pausabater13/IRIintern_2023spring/hardware/README.md

# Thurst Controller Hardware :notebook:

> Hardware files related to the HiDRo thrust controller board.

The hardware CAD files of the board have been created using Kicad.

Inside the **thrust_controller** folder you can find :

- the electrical schematic (*thrust_controller.kicad_sch*)
- the pcb design (*thrust_controller.kicad_pcb*)
- the fabrication files (in **fabrication_outputs**)
