pausabater13/IRIintern_2023spring/documentation/thrust_components.md

# Bill of Materials

## Analog circuits

- [Instrumentation amplifier AD620](https://www.mouser.es/ProductDetail/584-AD620ARZ) **x 1**
- [Operational amplifier OPA317ID](https://www.mouser.es/ProductDetail/595-OPA317IDR) **x 1**

## Digital circuits

- [Microcontroller STM32L011F4P](https://www.mouser.es/ProductDetail/511-STM32L011F4P6) **x 1**
- [RS485 Tranceiver MAX1487ESA](https://www.mouser.es/ProductDetail/700-MAX1487CSA) **x 1**

## Power regulators

- [Linear regulator TPS79133](https://www.mouser.es/ProductDetail/595-TPS79133DBVR) **x 2**

## Connectors

> For pixhawk & esc

- [3 pins horizontal header](https://www.mouser.es/ProductDetail/855-M20-8900305) **x 2**

> For debug & RS485

- [4 pins gh connector](https://es.rs-online.com/web/p/conectores-macho-para-pcb/7521797) **x 3**

## Passive components

 > For power decoupling

- [0.1uF capacitor](https://www.mouser.es/ProductDetail/80-C0805C104K8RAUTO) **x 15**
- [1uF capacitor](https://www.mouser.es/ProductDetail/80-C0805C105K4R7800) **x 2**
- [10uF capacitor](https://www.mouser.es/ProductDetail/80-C0805C106K8P) **x 4**

 > For the analog section

- [10uF Tantalum capacitor](https://www.mouser.es/ProductDetail/74-TMCP1A106KTRF) **x 1**

> For visual checking

- [Blue led](https://www.mouser.es/ProductDetail/604-APA2107LVBCD) **x 1**
- [Green led](https://www.mouser.es/ProductDetail/604-APA2107LZGCK) **x 1**

> For the diodes

- [1.18k Ohm resistor](https://www.mouser.es/ProductDetail/71-CRCW0805-1.18K-E3) **x 1**
- [330 Ohm resistor](https://www.mouser.es/ProductDetail/71-CRCW0805330RFKEAC) **x 1**

> For the voltage divider

- [200 Ohm resistor](https://www.mouser.es/ProductDetail/71-CRCW0805200RFKEBC) **x 1**
- [100 Ohm resistor](https://www.mouser.es/ProductDetail/71-CRCW0805100RFKEAC) **x 1**
