pausabater13/IRIintern_2023spring/hardware/thrust_controller/thrust_controller.kicad_pcb

## KiCad design hardware/thrust_controller/thrust_controller.kicad_pcb (2023-05-12)

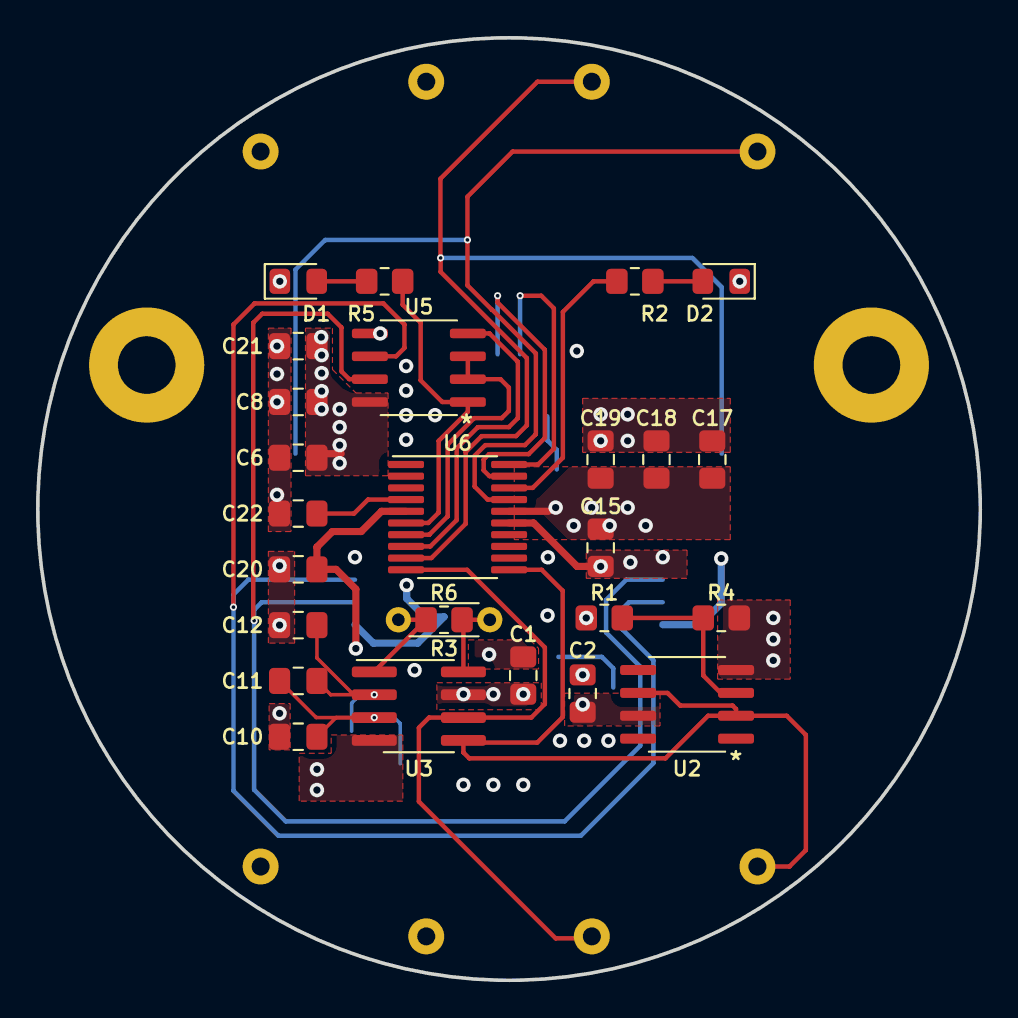
[picture p1: board thrust_controller.kicad_pcb from above]

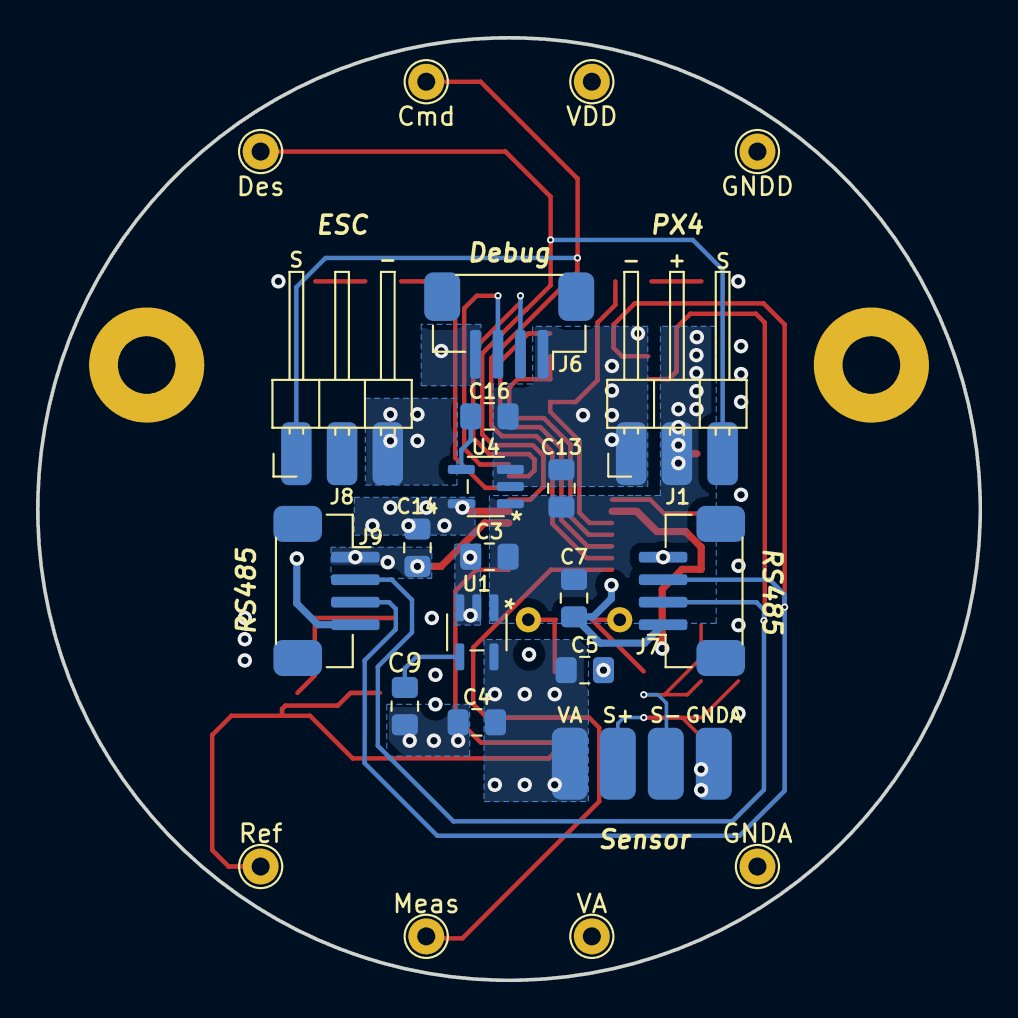
[picture p2: board thrust_controller.kicad_pcb from below]

Board: 4 copper layers, 52.4 x 52.4 mm, 55 parts (27 on the bottom side), 26 nets.

Parts:
C1, C2, C3, C9, C10, C11, C12, C13, C16, C17, C18, C19, C20, C21, C22: 0.1 μF; C_0805_2012Metric_Pad1.18x1.45mm_HandSolder
C4, C14: 1 μF; C_0805_2012Metric_Pad1.18x1.45mm_HandSolder
C5: 10 μF Tantalum; C_0805_2012Metric_Pad1.18x1.45mm_HandSolder
C6, C7, C8, C15: 10 μF; C_0805_2012Metric_Pad1.18x1.45mm_HandSolder
D1: BLUE LED; LED_0805_2012Metric_Pad1.15x1.40mm_HandSolder
D2: YELLOW LED; LED_0805_2012Metric_Pad1.15x1.40mm_HandSolder
H1, H2: MountingHole; MountingHole_3.2mm_M3_Pad
J1: px4_con; PinHeader_1x03_P2.54mm_Horizontal
J2: VS; SolderWirePad_1x01_SMD_1x2mm
J3: S+; SolderWirePad_1x01_SMD_1x2mm
J4: S-; SolderWirePad_1x01_SMD_1x2mm
J5: GND; SolderWirePad_1x01_SMD_1x2mm
J6: debug_con; JST_GH_SM04B-GHS-TB_1x04-1MP_P1.25mm_Horizontal
J7, J9: rs485_con; JST_GH_SM04B-GHS-TB_1x04-1MP_P1.25mm_Horizontal
J8: esc_con; PinHeader_1x03_P2.54mm_Horizontal
R1, R4: R; R_0805_2012Metric_Pad1.20x1.40mm_HandSolder
R2: 260 Ω; R_0805_2012Metric_Pad1.20x1.40mm_HandSolder
R3: Rg; R_0805_2012Metric_Pad1.20x1.40mm_HandSolder
R5: 440 Ω; R_0805_2012Metric_Pad1.20x1.40mm_HandSolder
R6: Test; R_Axial_DIN0204_L3.6mm_D1.6mm_P5.08mm_Horizontal
TP1, TP2, TP3, TP4, TP5, TP6, TP7, TP8: TestPoint; TestPoint_THTPad_D2.0mm_Drill1.0mm
U1, U4: TPS79133DBVT
U2: OPA317ID
U3: AD620; SOIC-8_3.9x4.9mm_P1.27mm
U5: MAX485E; MAX1487ESA&plus_
U6: STM32L011F4Px; TSSOP-20_4.4x6.5mm_P0.65mm

Connections:
+3.3V: C14.1, C15.1, C17.1, C18.1, C19.1, J6.4, J7.4, J9.4, TP5.1, U4.5 (OUT), U6.16 (VDD)
+3.3VA: C1.1, C2.1, C4.1, C5.1, C10.1, C20.1, J2.1, R1.1, TP1.1, U1.5 (OUT), U2.7 (V+), U3.7 (Vs+), U6.5 (VDDA)
+5V: C3.1, C6.1, C7.1, C8.1, C13.1, C21.1, J1.2, U1.1 (IN), U4.1 (IN), U5.8 (VCC)
A: J7.3, J9.3, U5.6 (A)
B: J7.2, J9.2, U5.7 (B)
Cmd: J8.1, TP7.1, U6.9 (PA3)
Des: J1.3, TP2.1, U6.17 (PA9)
GNDA: C1.2, C2.2, C3.2, C4.2, C5.2, C6.2, C7.2, C8.2, C9.2, C12.2, C13.2, C14.2, C15.2, C16.2, C17.2, C18.2, C19.2, C20.2, C21.2, C22.2, D1.1 (K), D2.1 (K), J1.1, J5.1, J6.1, J7.1, J8.3, J9.1, R4.2, TP6.1, TP8.1, U1.2 (GND), U1.3 (*EN), U2.4 (V-), U3.4 (Vs-), U4.2 (GND), U4.3 (*EN), U5.5 (GND), U6.15 (VSS)
Meas: TP3.1, U3.6, U6.10 (PA4)
unnamed: C9.1, U1.4 (BP)
unnamed: C16.1, U4.4 (BP)
unnamed: C22.1, U6.4 (NRST)
unnamed: D1.2 (A), R5.1
unnamed: D2.2 (A), R2.2
unnamed: R1.2, R4.1, U2.3 (+)
unnamed: R2.1, U6.18 (PA10)
unnamed: R3.1, R6.1, U3.1 (Rg)
unnamed: R3.2, R6.2, U3.8 (Rg)
unnamed: U5.2 (~RE), U5.3 (DE), U6.7 (PA1)
Ref: TP4.1, U2.2 (-), U2.6, U3.5 (Ref), U6.11 (PA5)
S+: C10.2, C11.1, J3.1, U3.3 (+)
S-: C11.2, C12.1, J4.1, U3.2 (-)
SWCLK: J6.3, U6.20 (PA14)
SWDIO: J6.2, U6.19 (PA13)
USART2_RX: R5.2, U5.1 (RO), U6.6 (PA0)
USART2_TX: U5.4 (DI), U6.8 (PA2)
