pausabater13/IRIintern_2023spring/firmware/5ADC_PWM_PulseLength/Core/Src/main.c

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
/* Includes ------------------------------------------------------------------*/
#include "main.h"

ADC_HandleTypeDef hadc;

TIM_HandleTypeDef htim2;
TIM_HandleTypeDef htim21;

void SystemClock_Config(void);
static void MX_GPIO_Init(void);
static void MX_TIM2_Init(void);
static void MX_ADC_Init(void);
static void MX_TIM21_Init(void);
/* USER CODE BEGIN 0 */
	//##############################ADC INPUT SENSOR - PID CONTROL############################
	float Thrust_measured = 0;//Newtons
	float Thrust_desired = 0;//Newtons
	//##############################PWM OUTPUT##############################
	uint32_t Frequency_output = 4000; //in Hertz. As we want a max pulse of 250us(Duty_output=100%)
	float Duty_output = 0; //From 0 to 1
	uint32_t Pulse_length_output = 150;//in us (microseconds)
	//############################## PWM INPUT##############################
	float Duty_input = 0; //Duty cycle coefficient: 0->0%, 1->100%
	uint32_t PWM_input_period = 0; //Period of the PWM function (counts timer clicks)
	uint32_t PWM_input_pulseON = 0; //Pulse width, of the positive part, on.
	uint32_t Frequency_input = 0;//Frequency of the PWM hole function (Hz)
	//#######################################################################
/* USER CODE END 0 */

/**
  * @brief  The application entry point.
  * @retval int
  */
int main(void)
{
  /* MCU Configuration--------------------------------------------------------*/

  /* Reset of all peripherals, Initializes the Flash interface and the Systick. */
  HAL_Init();

  /* Configure the system clock */
  SystemClock_Config();

  /* Initialize all configured peripherals */
  MX_GPIO_Init();
  MX_TIM2_Init();
  MX_ADC_Init();
  MX_TIM21_Init();
  /* USER CODE BEGIN 2 */
  	  //##############################PWM INPUT##############################
  	  // Main channel (Function Period Measure):
  	  HAL_TIM_IC_Start_IT(&htim21, TIM_CHANNEL_2);
  	  // Indirect channel (Pulse Width Measure):
  	  HAL_TIM_IC_Start(&htim21, TIM_CHANNEL_1);
	  //##############################PWM OUTPUT##############################
	  HAL_TIM_PWM_Start_IT(&htim2, TIM_CHANNEL_4); //Generation initialization.
  /* USER CODE END 2 */

  /* Infinite loop */
  /* USER CODE BEGIN WHILE */
  while (1)
  {
    /* USER CODE END WHILE */

    /* USER CODE BEGIN 3 */
  }
  /* USER CODE END 3 */
}

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
/* USER CODE BEGIN 4 */
float max(float a, float b){if(a>b) return a; else return b;}
float min(float a, float b){if(a>b) return b; else return a;}
float linear_map (float x, float minIN, float maxIN, float minOUT, float maxOUT){
//LINEAR MAPPING from [minIN, maxIN] to [minOUT, maxOUT]
return (x-minIN)*(maxOUT-minOUT)/(maxIN-minIN)+minOUT;}


float integration = 0;
float previous_error = 0;
float PID(float Thrust_desired, float Thrust_measured){
	//To be tunned:
	const float Kff = 1; //Constant for Proportionality directly over desired thrust
	const float Kp = 1.3; //Constant of proportionality over error.
	const float Ki = 0; //Constant of integration
	const float Kd = 0; //Constant of derivation

	float error = 0;
	if(Thrust_measured != 0){
		error = Thrust_desired - Thrust_measured;
	}
	float dt =1;//250/1000000;//250us, As the PID function is evaluated every, due to ADC interrupt function.
	float derivation = (error-previous_error)/dt;
	integration += error*dt;
	//PID
	float Thrust_output = (Kff * Thrust_desired)+(Kp*error)+(Kd*derivation)+(Ki*integration);

	//ANTI-WIND-UP SHIELD. Avoids saturation--------------
	if(Thrust_output > 25){
		integration -= error;
		Thrust_output = 25;//Upper bound
	}
	if(Thrust_output < 0){
		integration -= error;
		Thrust_output = 0;//Lower bound
	}
	//-----------------------------------------------------
	//Security value: not desire input:--------------------
	if(Thrust_desired < 0 || Thrust_desired > 25){
		Thrust_output = 0;
	}
	//-----------------------------------------------------

	previous_error = error;
	return Thrust_output;
}

//################### ADC CONVERSION and PID control #####################
//Frequency of 4kHz as it is initialized in tim2 interrupt HAL_ADC_Start_IT(&hadc);
void HAL_ADC_ConvCpltCallback(ADC_HandleTypeDef* hadc1)
{
	//t_ADC = (t_ADC + 20)%65535;
	//ADC conversion:--------------------------------------------
	Thrust_measured = linear_map(HAL_ADC_GetValue(hadc1) - 577, 1650, 3300, 0, 25);//577 is the offset modification.
	//1650 and 3000 need calibration, as the ADC input value is not estandard, at rest: 1650 aprox.

	//PID control -----------------------------------------------
	float Thrust_PID = PID(Thrust_desired, Thrust_measured);//When tunned, PID function should be replaced by PID_tunned
	//Thrust_PID = Thrust_measured;//test if ADC reading is working.
	//Thrust_PID = Thrust_desired;//test if PWM reading is working.

	Pulse_length_output = linear_map(Thrust_PID, 0, 25, 125, 250);//125 needs calibration (helix weight).

	//Output generation------------------------------------------
	Duty_output=linear_map(Pulse_length_output, 0,250, 0, 1);
	TIM2->CCR4 = (Duty_output*800);//Duty generation configuration. ARR4=800 as Frequency_out is 4kHz
}

//###################PWM INPUT INTERRUPT FUNCTION #####################

void HAL_TIM_IC_CaptureCallback(TIM_HandleTypeDef *htim){

	// Check which version of the timer triggered
	if(htim == &htim21)
	{ //It's called each 10*10000/32000000=3.215ms, as the input PWM frequency is 400Hz
		// If the interrupt is triggered by channel 2
		if (htim->Channel == HAL_TIM_ACTIVE_CHANNEL_2){
			// Read the IC value
			PWM_input_period = HAL_TIM_ReadCapturedValue(htim, TIM_CHANNEL_2);
			//If it ́s not the initial 0 capture (=>no pulse registered)
			if (PWM_input_period != 0){
				PWM_input_pulseON = HAL_TIM_ReadCapturedValue(htim, TIM_CHANNEL_1);
				// Compute the Duty Cycle
				Duty_input = (float)(PWM_input_pulseON)/(float)PWM_input_period;
				//Compute the frequency of the PWM. 32000000 is the timer frequency
				//Frequency_input = 32000000/(PWM_input_period);//Divide also by prescaler if us

				//Computing the Thrust desired.
				Thrust_desired = linear_map(Duty_input, 0.5, 1, 0, 25);//Depends on the comunication protocol?
			}
		}
	}
}
void HAL_TIM_PWM_PulseFinishedCallback(TIM_HandleTypeDef* htim)
{//Every 250us (microseconds) as the frequency is 400kHz
	if(htim == &htim2)
	{
		//ADC conversion:--------------------------------------------
		HAL_ADC_Start_IT(&hadc);
		//As we are not in continues conversion mode, need to reinitialize
	}
}
/* USER CODE END 4 */
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
