pausabater13/IRIintern_2023spring/firmware/firmware.ioc

Mcu.UserName=STM32L011F4Px
PA0-CK_IN.Signal=USART2_RX
PA10.GPIO_Label=STATUS_LED
PA10.Signal=GPIO_Input
PA13.Signal=SYS_SWDIO
PA14.Signal=SYS_SWCLK
PA2.Signal=USART2_TX
PA3.GPIO_Label=CMD_PWM_OUT
PA3.Signal=S_TIM2_CH4
PA4.GPIO_Label=MEAS_ANL_IN
PA4.Signal=SharedAnalog_PA4
PA5.GPIO_Label=REF_ANL_IN
PA5.Signal=SharedAnalog_PA5
PA9.GPIO_Label=DES_PWM_IN
PA9.Signal=S_TIM21_CH2
