pausabater13/IRIintern_2023spring/(commit log)

2023-05-12 Create Thrust_control.c
    STM32 CubeIDE main.c for thrust control with ADC, TIM2 for PWM generation and TIM21 with channels 1 and 2 for pulse length input reading.
2023-05-12 feat: Add last internship updates
    [thrust_controller-B_Cu.gbr, thrust_controller-B_Mask.gbr, thrust_controller-B_Paste.gbr, thrust_controller-B_Silkscreen.gbr, thrust_controller-Edge_Cuts.gbr, thrust_controller-F_Cu.gbr, thrust_controller-F_Mask.gbr, thrust_controller-F_Paste.gbr]
